oli528/StorePi/Electronics/Computations/Book1.xlsx

 | KSZ9563RNX |  | Current
 | A | D | mA
1.2 |  | ✓ | 250 |  | 5 | TPS65251-1RHAR | Analog
1.2 | ✓ |  | 190
2.5 | ✓ |  | 140 |  |  | TPS62420DRCTG4 | Digital
1.8 |  | ✓ | 35
 | ASM1184
 | A | D
1.2 |  | ✓ | 300
3.3 | ✓ |  | 1000
 | ASM1352R
 | A | D
3.3 |  | ✓ | 95
1.2 |  | ✓ | 440
1.2 | ✓
PG | Out |  | Detination | PG | IN | Origin
4 | PCIE_PWR_EN |  | 8 | 4 | PCIE_nCLKREQ | 8
4 | PCIE_CLK_P |  | 8 | 4 | PCIE_nWAKE | 8
4 | PCIE_CLK_N |  | 8 | 4 | PCIE_RX_P | 8
4 | PCIE_TX_P |  | 8 | 4 | PCIE_RX_N | 8
4 | PCIE_TX_N |  | 8 | 4 | USB3-0-RX_N | 9
4 | USB3-0-TX_N |  | 9 | 4 | USB3-0-RX_P | 9
4 | USB3-0-TX_P |  | 9 | 4 | USBOTG | 5
4 | PCIE_nRST |  | 8 | 4 | USB3-1-RX_N | 10
4 | USB3-1-TX_N |  | 10 | 4 | USB3-1-RX_P | 10
4 | USB3-1-TX_P |  | 10 | 4 | GPIO_VREF | 5
4 | USB2_N |  | 11 | 4 | ID_SC | 5
4 | USB2_P |  | 11 | 4 | ID_SD | 5
5 | ID_SD |  | 4 | 4 | CAM_GPIO0 | 5
5 | ID_SC |  | 4 | 4 | CAM_GPIO1 | 5
5 | GPIO_VREF |  | 4 | 4 | SCL0 | 5
5 | SCL0 |  | 4 | 4 | SDA0 | 5
5 | SDA0 |  | 4 | 4 | 3V3 | 7
5 | 3V3 |  | 7 | 5 | 5V S1 | 6
5 | CAM_GPIO0 |  | 4 | 5 | 12V | 6
5 | CAM_GPIO1 |  | 4 | 6 | Main Shut | 12
6 | 12V |  | 7, 9, 10 | 7 | 5V S1 | 6
7 | 5V S1 |  | 4,5,7,8,11,12 | 7 | 12V | 6
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
