oli528/StorePi/Electronics/Documentation/Specification.docx

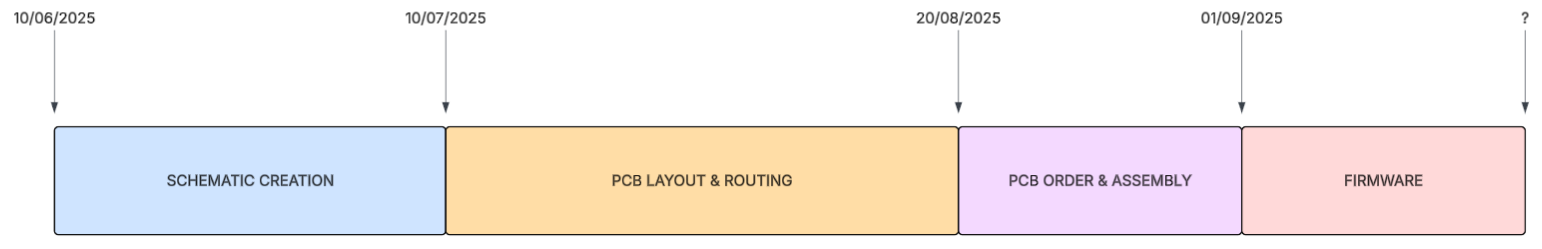
[picture p1: figure]
