oli528/StorePi/(list of files, drawings)

Other design files:
Electronics/Imported CM5 Nas/4DB-P108-03.SchLib
Electronics/Imported CM5 Nas/47018-2000.SchLib
Electronics/Imported CM5 Nas/10029364-001LF.SchLib
Electronics/Imported CM5 Nas/0039281063.SchLib
Electronics/Imported CM5 Nas/0877131001.SchLib
Electronics/Imported CM5 Nas/AOZ2255EQI-30.SchLib
Electronics/Imported CM5 Nas/AP62800SJ-7.SchLib
Electronics/Imported CM5 Nas/ASM1352R.SchLib
Electronics/Imported CM5 Nas/Block Diagram.SchDoc
Electronics/Imported CM5 Nas/CM5 Nas.PcbDoc
Electronics/Imported CM5 Nas/CM5 Nas.PrjPcb
Electronics/Imported CM5 Nas/CM5 Nas.SchDoc
Electronics/Imported CM5 Nas/CM5 Nas.SchLib
Electronics/Imported CM5 Nas/Drives_M.2.SchDoc
Electronics/Imported CM5 Nas/HD3SS3412RUAT.SchLib
Electronics/Imported CM5 Nas/JMS561.SchLib
Electronics/Imported CM5 Nas/JXD0-4015NL.SchLib
Electronics/Imported CM5 Nas/LM61480Q3RPHRQ1.SchLib
Electronics/Imported CM5 Nas/MAX20008AFOC_VY+T.SchLib
Electronics/Imported CM5 Nas/PI7C9X2G404ELZXAE.SchLib
Electronics/Imported CM5 Nas/Power.SchDoc
Electronics/Imported CM5 Nas/Project Architecture.SchDoc
Electronics/Imported CM5 Nas/RB1-125BAG1A.SchLib
Electronics/Imported CM5 Nas/RD-125A.SchLib
Electronics/Imported CM5 Nas/Revision History.SchDoc
Electronics/Imported CM5 Nas/RJMG212S21130ER.SchLib
Electronics/Imported CM5 Nas/SAT3M3232042TR.SchLib
Electronics/Imported CM5 Nas/Sata_Drives2.SchDoc
Electronics/Imported CM5 Nas/Sata_Drives.SchDoc
Electronics/Imported CM5 Nas/Section A - Title A.SchDoc
Electronics/Imported CM5 Nas/Section B - TItle B.SchDoc
Electronics/Imported CM5 Nas/SJA1105PEL.SchLib
Electronics/Imported CM5 Nas/SJA1105RELY.SchLib
Electronics/Imported CM5 Nas/SLG59M1717V.SchLib
Electronics/Imported CM5 Nas/TPS62420DRCTG4.SchLib
Electronics/Imported CM5 Nas/TPS65251-1RHAR.SchLib
Electronics/Imported CM5 Nas/TUSB9261IPVP.SchLib
Electronics/Imported CM5 Nas/untitled.SchDoc
Electronics/Imported CM5 Nas/USB2512B-AEZG.SchLib
Electronics/Imported CM5 Nas/USB & Ethernet.SchDoc
Electronics/Imported CM5 Nas/XT60PW-M.SchLib
