oli528/StorePi/Electronics/CM5 Nas.kicad_pcb

## KiCad design Electronics/CM5 Nas.kicad_pcb (2025-08-04)

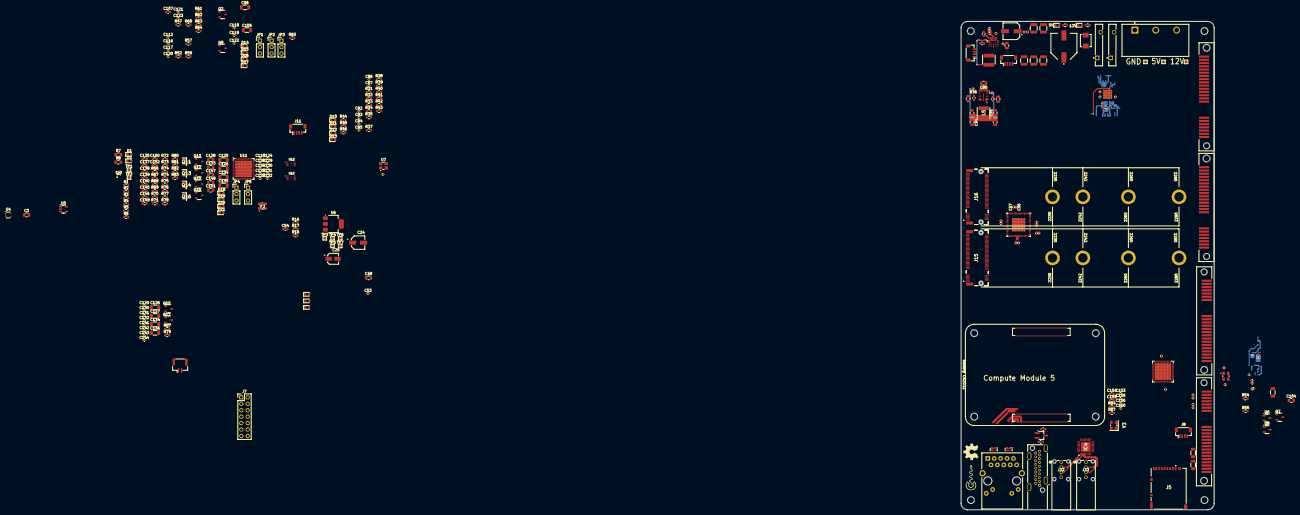
[picture p13: board CM5 Nas.kicad_pcb from above]

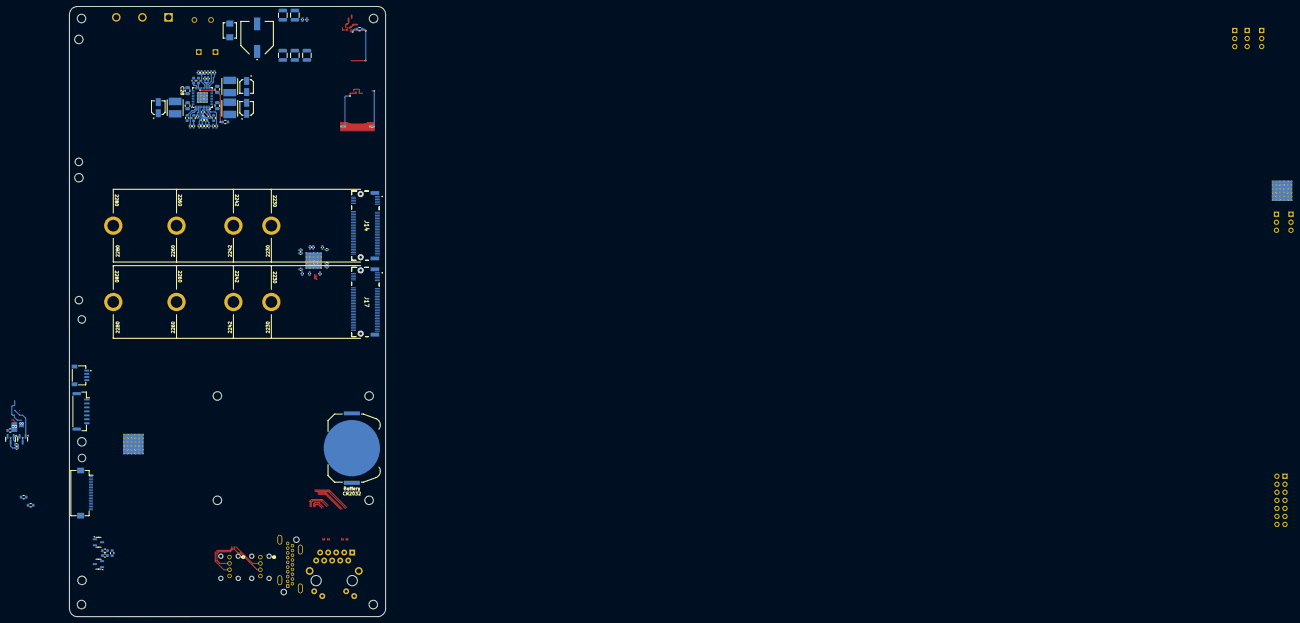
[picture p14: board CM5 Nas.kicad_pcb from below]

Board: 4 copper layers, 100.0 x 193.0 mm, 370 parts (78 on the bottom side), 312 nets.

Parts:
+5V1, +12V1: TestPoint; TestPoint_Pad_1.0x1.0mm
BT1: Battery_Cell; BatteryHolder_Keystone_3034_1x20mm
C1, C2, C42, C54, C137, C138, C139, C140, C145, C146, C149, C150, C152, C154, C159: 100n; C_0603_1608Metric
C3, C77, C81: 10u; C_0805_2012Metric
C4, C12: 1u; C_1210_3225Metric
C5, C13: 1000u; EEE0JA152UAP
C6, C7, C8, C9, C14, C15, C16, C17: 10u; C_1210_3225Metric
C10, C11, C18, C19, C44, C56, C57, C58, C59, C60, C61, C62, C63, C64, C65, C66, C67, C68, C69, C70, C71, C72, C73, C74, C75, C76, C79, C82, C83, C84, C85, C86, C87, C88, C89, C109, C110, C111, C112, C116, C117, C120, C121, C123#2: 100n; C_0402_1005Metric
C20, C21, C27, C28: 22u; C_0805_2012Metric
C22, C50, C51: 100p; C_0402_1005Metric
C23: 10u; C_0603_1608Metric
C24: 10u; CAP_EEEFK1H100UR
C25, C32, C34, C37: 22u; CAP_EEEFK1A220AR
C26, C30, C31, C38, C39, C40, C41, C46, C47: 4n7; C_0402_1005Metric
C29: 3u3; C_0603_1608Metric
C33, C35, C36: 47n; C_0402_1005Metric
C43: 100u; CAP_EEEFTH101XAP
C45, C48: 4u7; C_0805_2012Metric
C49, C53: 4u7; C_0402_1005Metric
C52: 2u2; C_0402_1005Metric
C55: 1n; C_0402_1005Metric
C78, C80: 0u47; C_0603_1608Metric
C90, C104, C128, C133, C147, C148, C151: 1u; C_0805_2012Metric
C91, C92, C93, C94: 47u; C_0805_2012Metric
C95, C96, C124, C125, C155, C156: 22p; C_0402_1005Metric
C96#2, C97, C98, C105, C106, C125#2, C126, C126#2, C127, C134, C134#2, C135, C136: 22u; C_1206_3216Metric
C99, C107, C135#2: 1u; C_0603_1608Metric
C100, C101, C102, C103, C108, C113, C114, C115, C119, C120#2, C123, C124#2, C129, C129#2, C130, C130#2, C131, C131#2, C132, C132#2, C141, C142, C143, C144: 10n; C_0402_1005Metric
C118, C119#2, C122: 1u; C_0402_1005Metric
C153, C160: 0u01; C_0402_1005Metric
D1, D3, D6, D7, D8, D9, D10, D11, D12, D13, D14, D15, D16, D17, D18, D19, D20, D21: LED Green; LED_0603_1608Metric
D2: LED Red; LED_0603_1608Metric
D4: D_TVS; SMBJ12A
D5: D_TVS; SMBJ5.0A
F1, F2: Polyfuse; RGEF1200
GND1: TestPoint; TestPoint_Pad_1.0x1.0mm
H1, H2, H3, H4, H5: MountingHole; MountingHole_2.7mm_M2.5
IC1: TPS65251-1RHAR; VQFN-40-1EP_6x6mm_P0.5mm_EP3.5x3.5mm_ThermalVias
IC2: MAX20008AFOC_VY+T; MAX20008AFOCVYT
IC3: LM61480Q3RPHRQ1; LM62460QRPHRQ1
IC4: USB2512B-AEZG; QFN50P600X600X100-37N-D
J1: HDMI_A; AMPHENOL_G45A19071083HR
J2: Conn_01x22_Female; Hirose_FH12-22S-0.5SH_1x22-1MP_P0.50mm_Horizontal
J3: RJ45_RB1-125B8G1A; RJ45_UDE_RB1-125B8G1A
J4: Conn_01x07; JST_GH_SM07B-GHS-TB_1x07-1MP_P1.25mm_Horizontal
J5: Micro_SD_Card_Det; DM3ATSFPEJM5
J6: Conn_01x04; SPARKFUN_PRT-14417
J7: Conn_02x07_Odd_Even; PinHeader_2x07_P2.54mm_Vertical
J8, J9, J11, J12: JST_SHBM04B-SRSS-TB; JST_SH_BM04B-SRSS-TB_1x04-1MP_P1.00mm_Vertical
J10: Conn_01x02; JST_GH_BM02B-GHS-TBT_1x02-1MP_P1.25mm_Vertical
J13: 4DB-P108-03; 4DBP10803
J14, J17: Bus_M.2_Socket_M; 21991195 no holes
J15, J16: Bus_M.2_Socket_M; 21991195
J18, J19, J20, J21: 0877131001; 87713-1001
J22, J23: USB_A; CONN_48204-0001_MOL
JP1, JP2, JP3, JP4, JP5: 3P_JUMPER; PinHeader_1x03_P2.54mm_Vertical
L1, L2, L3: 4u7; INDPM5050X400N
L4: 1u; SRN5040TA1R0M
L5: 2u2; SRN50402R2Y
Module1: ComputeModule5-CM5; Raspberry-Pi-5-Compute-Module
Q1: PMOS; BSS84AKW115
Q2, Q10, Q10#2, Q12, Q15, Q15#2, Q17: NPN; P200_SOT-23
Q2#2: MMBT3904; SOT-23
Q3, Q5, Q6, Q8: AOSS21311C; SOT-23-3
Q4: AOSS21311C; SOT-23
Q7, Q9: MMBT3904; P200_SOT-23
Q11, Q13, Q14, Q16: PMOS; SOT95P237X117-3N
R1, R2, R3, R18, R37, R38, R39, R40, R84: 1K; R_0603_1608Metric
R4, R43, R44, R45, R46: 1k; R_0603_1608Metric
R5, R6, R58, R71, R77: 4K7; R_0603_1608Metric
R7: 0R; R_0805_2012Metric_Pad1.20x1.40mm_HandSolder
R8: nf; R_0805_2012Metric_Pad1.20x1.40mm_HandSolder
R9: 2K2; R_0603_1608Metric
R10: 620; R_0603_1608Metric
R11: 20k; R_0402_1005Metric
R12, R31, R32, R33, R34, R35: 10K; R_0603_1608Metric
R13, R25: 80K6; R_0402_1005Metric
R14: 150k; R_0402_1005Metric
R15, R19, R20: 40K2; R_0402_1005Metric
R16, R17, R61, R62, R63, R64, R80, R81, R82, R83: 270; R_0603_1608Metric
R21: 120k; R_0603_1608Metric
R22: 150k; R_0603_1608Metric
R23: 20K; R_0603_1608Metric
R24: 12K7; R_0402_1005Metric
R26: 383k; R_0402_1005Metric
R27, R28: 20k; R_0603_1608Metric
R29: 22K; C_0402_1005Metric
R30: 12k; R_0603_1608Metric
R36: 10k; R_0402_1005Metric
R41, R42: 12K1; R_0603_1608Metric
R47, R52, R66, R72, R87: 12K; R_0603_1608Metric
R48, R49, R50, R54, R55, R56, R60, R65, R67, R67#2, R68, R69, R70, R73, R74, R74#2, R75, R79: 100K; R_0603_1608Metric
R51: 100K; R_0402_1005Metric
R53: 4K7; R_0402_1005Metric
R57, R76: 10; R_0603_1608Metric
R59, R78: 4K7 1%; R_0603_1608Metric
TP1, TP2, TP3, TP4, TP5, TP6, TP7: TestPoint; TestPoint_Pad_1.0x1.0mm
U1: RT9742SNGV; TSOT-23_HandSoldering
U2, U3: TPD4EUSB30; USON-10_2.5x1.0mm_P0.5mm
U4: 74LVC1G07SE-7; SOT-353_SC-70-5
U5: RT9742GGJ5; SOT-23-5
U6: AMS1117-3.3; SOT-223-3_TabPin2
U7: ASEK-32.768KHZ-L-R-T; Crystal_SMD_3225-4Pin_3.2x2.5mm
U8: ASM1184; QFN-64-1EP_9x9mm_P0.5mm_EP5.2x5.2mm_ThermalVias
U9, U11: JMS561; QFN-64-1EP_8x8mm_P0.4mm_EP6.5x6.5mm_ThermalVias
U10, U12: W25X20CLUXIG_TR; SON50P300X200X60-9N
Y1, Y2, Y3: 30MHz; ABM810000MHZ12D2W

Connections:
+1V2: C58.1, C59.1, C60.1, C61.1, C62.1, C63.1, C69.1, C70.1, C71.1, C72.1, C73.1, C74.1, U8.9 (1V2), U8.15 (1V2), U8.17 (1V2), U8.20 (1V2), U8.26 (1V2), U8.29 (1V2), U8.37 (1V2), U8.43 (1V2), U8.48 (1V2), U8.50 (1V2), U8.61 (1V2), U8.64 (1V2)
+3V3A: C82.1, C83.1, C84.1, C85.1, C86.1, C87.1, R31.1, R32.1, R33.1, R34.1, R35.1, U8.1 (3V_AUX), U8.10 (3V3), U8.21 (3V3), U8.32 (3V3), U8.38 (3V3), U8.56 (3V3)
+5V: R67.1, R74.1
+5V S1: C12.1, C13.1, C14.1, C15.1, C16.1, C17.1, C18.1, C19.1, D5.2 (A2), F2.2
+5V S2: Q5.3 (S), Q8.3 (S), Q13.3 (S), Q16.3 (S), R48.2, R60.1, R67#2.2, R79.2
+5V-HDD0: C96#2.1, C98.2, J18.14 (P7), J18.15 (P8), J18.16 (P9), Q5.1 (D)
+5V-HDD1: C106.2, J19.14 (P7), J19.15 (P8), J19.16 (P9), Q8.1 (D)
+5V-HDD2: C125#2.1, C127.2, J20.14 (P7), J20.15 (P8), J20.16 (P9), Q13.1 (D)
+5V-HDD3: C134.1, C136.2, J21.14 (P7), J21.15 (P8), J21.16 (P9), Q16.1 (D)
+12V: +12V1.1, C4.1, C5.1, C6.1, C7.1, C8.1, C9.1, C10.1, C11.1, C99.1, C104.1, C128.1, C133.1, D4.2 (A2), F1.1, F1.2, J13.3, Q3.3 (S), Q6.3 (S), Q11.3 (S), Q14.3 (S), R9.2, R49.2, R54.2, R68.2, R73.2
+12V-HDD0: C97.1, J18.20 (P13), J18.21 (P14), J18.22 (P15), Q3.1 (D)
+12V-HDD1: C105.1, J19.20 (P13), J19.21 (P14), J19.22 (P15), Q6.1 (D)
+12V-HDD2: C126.1, C126#2.1, J20.20 (P13), J20.21 (P14), J20.22 (P15), Q11.1 (D)
+12V-HDD3: C134#2.1, C135.1, J21.20 (P13), J21.21 (P14), J21.22 (P15), Q14.1 (D)
/Project Architecture/CM5_GPIO/+3V3: D1.2 (A), D2.2 (A), J3.L1, J3.L3, J3.R1 (CT), J4.1, J6.2, Module1.84 (+3.3v_(Output)), Module1.86 (+3.3v_(Output)), R5.1, R6.1, R7.1, U4.5 (VCC), U5.5 (IN)
/Project Architecture/CM5_GPIO/+5V: J11.1, Module1.77 (+5v_(Input)), Module1.79 (+5v_(Input)), Module1.81 (+5v_(Input)), Module1.83 (+5v_(Input)), Module1.85 (+5v_(Input)), Module1.87 (+5v_(Input))
/Project Architecture/CM5_GPIO/+12V: J8.1, J9.1, J12.1
/Project Architecture/CM5_GPIO/CM5 Shut: Module1.54 (GPIO4), Q1.2 (G)
/Project Architecture/CM5_GPIO/EEPROM_nWP: J7.4, Module1.20 (EEPROM_nWP)
/Project Architecture/CM5_GPIO/ETH_LEDG: Module1.17 (Ethernet_nLED2(3.3v)), R1.1
/Project Architecture/CM5_GPIO/ETH_LEDY: Module1.15 (Ethernet_nLED3(3.3v)), R2.1
/Project Architecture/CM5_GPIO/GPIO2: J6.4, Module1.58 (GPIO2), R6.2
/Project Architecture/CM5_GPIO/GPIO3: J6.3, Module1.56 (GPIO3), R5.2
/Project Architecture/CM5_GPIO/GPIO8: J4.5, Module1.39 (GPIO8)
/Project Architecture/CM5_GPIO/GPIO10: J4.3, Module1.44 (GPIO10)
/Project Architecture/CM5_GPIO/GPIO11: J4.4, Module1.38 (GPIO11)
/Project Architecture/CM5_GPIO/GPIO25: J4.6, Module1.41 (GPIO25)
/Project Architecture/CM5_GPIO/GPIO27: J4.7, Module1.48 (GPIO27)
/Project Architecture/CM5_GPIO/GPIO_VREF: Module1.78 (GPIO_VREF(1.8v/3.3v_Input)), R7.2, R8.2
/Project Architecture/CM5_GPIO/PMIC_ENABLE: J7.12, Module1.99 (PMIC_ENABLE)
/Project Architecture/CM5_GPIO/PWM_0: J11.2, Module1.19 (FAN_PWM)
/Project Architecture/CM5_GPIO/PWM_1: J8.2, Module1.31 (GPIO12)
/Project Architecture/CM5_GPIO/PWM_2: J9.2, Module1.28 (GPIO13)
/Project Architecture/CM5_GPIO/PWM_3: J12.2, Module1.55 (GPIO14)
/Project Architecture/CM5_GPIO/PWR_BUT: J7.14, J10.1, Module1.92 (PWR_BUT), Q1.1 (D)
/Project Architecture/CM5_GPIO/SD_CLK: J5.5 (CLK), Module1.57 (SD_CLK)
/Project Architecture/CM5_GPIO/SD_CMD: J5.3 (CMD), Module1.62 (SD_CMD)
/Project Architecture/CM5_GPIO/SD_DAT0: J5.7 (DAT0), Module1.63 (SD_DAT0)
/Project Architecture/CM5_GPIO/SD_DAT1: J5.8 (DAT1), Module1.67 (SD_DAT1)
/Project Architecture/CM5_GPIO/SD_DAT2: J5.1 (DAT2), Module1.69 (SD_DAT2)
/Project Architecture/CM5_GPIO/SD_DAT3: J5.2 (DAT3/CD), Module1.61 (SD_DAT3)
/Project Architecture/CM5_GPIO/SD_PWR: C3.1, J5.4 (VDD), U5.1 (OUT)
/Project Architecture/CM5_GPIO/SD_PWR_ON: Module1.75 (SD_PWR_ON), U5.4 (EN)
/Project Architecture/CM5_GPIO/SYNC_OUT: J7.6, Module1.18 (Ethernet_SYNC_OUT(3.3v))
/Project Architecture/CM5_GPIO/TACHO: J11.4, Module1.16 (FAN_TACHO)
/Project Architecture/CM5_GPIO/TRD0_N: J3.R3 (TD1-), Module1.10 (Ethernet_Pair0_N), U3.4 (D2+), U3.7
/Project Architecture/CM5_GPIO/TRD0_P: J3.R2 (TD1+), Module1.12 (Ethernet_Pair0_P), U3.5 (D2-), U3.6
/Project Architecture/CM5_GPIO/TRD1_N: J3.R5 (TD2-), Module1.6 (Ethernet_Pair1_N), U3.2 (D1-), U3.9
/Project Architecture/CM5_GPIO/TRD1_P: J3.R4 (TD2+), Module1.4 (Ethernet_Pair1_P), U3.1 (D1+), U3.10
/Project Architecture/CM5_GPIO/TRD2_N: J3.R7 (TD3-), Module1.9 (Ethernet_Pair2_N), U2.4 (D2+), U2.7
/Project Architecture/CM5_GPIO/TRD2_P: J3.R6 (TD3+), Module1.11 (Ethernet_Pair2_P), U2.5 (D2-), U2.6
/Project Architecture/CM5_GPIO/TRD3_N: J3.R9 (TD4-), Module1.5 (Ethernet_Pair3_N), U2.2 (D1-), U2.9
/Project Architecture/CM5_GPIO/TRD3_P: J3.R8 (TD4+), Module1.3 (Ethernet_Pair3_P), U2.1 (D1+), U2.10
/Project Architecture/CM5_GPIO/VBAT: BT1.1 (+), Module1.76 (VBAT)
/Project Architecture/CM5_GPIO/nPWR_LED: Module1.95 (LED_nPWR), U4.2
/Project Architecture/CM5_GPIO/nRPIBOOT: J7.2, Module1.93 (nRPIBOOT)
/Project Architecture/CM5_High Speed IO/+5V S1: C1.1, U1.1 (IN)
/Project Architecture/CM5_High Speed IO/DPHY0_C_N: J2.8, Module1.127 (MIPI0_C_N)
/Project Architecture/CM5_High Speed IO/DPHY0_C_P: J2.9, Module1.129 (MIPI0_C_P)
/Project Architecture/CM5_High Speed IO/DPHY0_D0_N: J2.2, Module1.115 (MIPI0_D0_N)
/Project Architecture/CM5_High Speed IO/DPHY0_D0_P: J2.3, Module1.117 (MIPI0_D0_P)
/Project Architecture/CM5_High Speed IO/DPHY0_D1_N: J2.5, Module1.121 (MIPI0_D1_N)
/Project Architecture/CM5_High Speed IO/DPHY0_D1_P: J2.6, Module1.123 (MIPI0_D1_P)
/Project Architecture/CM5_High Speed IO/DPHY0_D2_N: J2.11, Module1.133 (MIPI0_D2_N)
/Project Architecture/CM5_High Speed IO/DPHY0_D2_P: J2.12, Module1.135 (MIPI0_D2_P)
/Project Architecture/CM5_High Speed IO/DPHY0_D3_N: J2.14, Module1.139 (MIPI0_D3_N)
/Project Architecture/CM5_High Speed IO/DPHY0_D3_P: J2.15, Module1.141 (MIPI0_D3_P)
/Project Architecture/CM5_High Speed IO/HDMI0_CEC: J1.13 (CEC), Module1.151 (HDMI0_CEC)
/Project Architecture/CM5_High Speed IO/HDMI0_CK_N: J1.12 (CK-), Module1.190 (HDMI0_CLK_N)
/Project Architecture/CM5_High Speed IO/HDMI0_CK_P: J1.10 (CK+), Module1.188 (HDMI0_CLK_P)
/Project Architecture/CM5_High Speed IO/HDMI0_D0_N: J1.9 (D0-), Module1.184 (HDMI0_TX0_N)
/Project Architecture/CM5_High Speed IO/HDMI0_D0_P: J1.7 (D0+), Module1.182 (HDMI0_TX0_P)
/Project Architecture/CM5_High Speed IO/HDMI0_D1_N: J1.6 (D1-), Module1.178 (HDMI0_TX1_N)
/Project Architecture/CM5_High Speed IO/HDMI0_D1_P: J1.4 (D1+), Module1.176 (HDMI0_TX1_P)
/Project Architecture/CM5_High Speed IO/HDMI0_D2_N: J1.3 (D2-), Module1.172 (HDMI0_TX2_N)
/Project Architecture/CM5_High Speed IO/HDMI0_D2_P: J1.1 (D2+), Module1.170 (HDMI0_TX2_P)
/Project Architecture/CM5_High Speed IO/HDMI0_HOTPLUG: J1.19 (HPD), Module1.153 (HDMI0_HOTPLUG)
/Project Architecture/CM5_High Speed IO/HDMI0_SCL: J1.15 (SCL), Module1.200 (HDMI0_SCL)
/Project Architecture/CM5_High Speed IO/HDMI0_SDA: J1.16 (SDA), Module1.199 (HDMI0_SDA)
/Project Architecture/CM5_High Speed IO/HDMI_5v: C2.1, J1.18 (+5V), U1.2 (OUT)
/Project Architecture/Input/+5V: +5V1.1, F2.1, J13.2
/Project Architecture/M.2 Drives/+3V3 M.2: C64.1, C91.1, C92.1, C93.1, C94.1, D10.2 (A), D11.2 (A), D12.2 (A), D13.2 (A), IC3.5 (BIAS), IC3.7 (FB), J14.2 (3.3V), J14.4 (3.3V), J14.70 (3.3V), J14.72 (3.3V), J14.74 (3.3V), J15.2 (3.3V), J15.4 (3.3V), J15.70 (3.3V), J15.72 (3.3V), J15.74 (3.3V), J16.2 (3.3V), J16.4 (3.3V), J16.70 (3.3V), J16.72 (3.3V), J16.74 (3.3V), J17.2 (3.3V), J17.4 (3.3V), J17.70 (3.3V), J17.72 (3.3V), J17.74 (3.3V), L5.2, R36.2, U7.1 (EN), U7.4 (VDD)
/Project Architecture/M.2 Drives/+5V S1: C77.2, C78.2, C80.1, C81.1, IC3.2 (VIN2), IC3.13 (EN), IC3.14 (VIN1)
/Project Architecture/M.2 Drives/BOOT: C79.1, IC3.16 (SW), L5.1
/Project Architecture/M.2 Drives/PCIE_nCLKREQ: J14.52 (~CLKREQ), J15.52 (~CLKREQ), J16.52 (~CLKREQ), J17.52 (~CLKREQ)
/Project Architecture/M.2 Drives/PCIE_nWAKE: J14.54 (~PEWAKE), J15.54 (~PEWAKE), J16.54 (~PEWAKE), J17.54 (~PEWAKE)
/Project Architecture/M.2 Drives/PCIe_CLK_N_1: J16.53 (REFCLKn), U8.19 (REFCLKN_1)
/Project Architecture/M.2 Drives/PCIe_CLK_N_2: J17.53 (REFCLKn), U8.28 (REFCLKN_2)
/Project Architecture/M.2 Drives/PCIe_CLK_N_3: J15.53 (REFCLKn), U8.45 (REFCLKN_3)
/Project Architecture/M.2 Drives/PCIe_CLK_N_4: J14.53 (REFCLKn), U8.63 (REFCLKN_4)
/Project Architecture/M.2 Drives/PCIe_CLK_P_1: J16.55 (REFCLKp), U8.18 (REFCLKP_1)
/Project Architecture/M.2 Drives/PCIe_CLK_P_2: J17.55 (REFCLKp), U8.27 (REFCLKP_2)
/Project Architecture/M.2 Drives/PCIe_CLK_P_3: J15.55 (REFCLKp), U8.44 (REFCLKP_3)
/Project Architecture/M.2 Drives/PCIe_CLK_P_4: J14.55 (REFCLKp), U8.62 (REFCLKP_4)
/Project Architecture/M.2 Drives/PCIe_RX_N_1: J16.41 (PETn0), U8.14 (RXN_1)
/Project Architecture/M.2 Drives/PCIe_RX_N_2: J17.41 (PETn0), U8.25 (RXN_2)
/Project Architecture/M.2 Drives/PCIe_RX_N_3: J15.41 (PETn0), U8.42 (RXN_3)
/Project Architecture/M.2 Drives/PCIe_RX_N_4: J14.41 (PETn0), U8.60 (RXN_4)
/Project Architecture/M.2 Drives/PCIe_RX_P_1: J16.43 (PETp0), U8.13 (RXP_1)
/Project Architecture/M.2 Drives/PCIe_RX_P_2: J17.43 (PETp0), U8.24 (RXP_2)
/Project Architecture/M.2 Drives/PCIe_RX_P_3: J15.43 (PETp0), U8.41 (RXP_3)
/Project Architecture/M.2 Drives/PCIe_RX_P_4: J14.43 (PETp0), U8.59 (RXP_4)
/Project Architecture/M.2 Drives/PCIe_TX_N_1: C57.1, J16.47 (PERn0)
/Project Architecture/M.2 Drives/PCIe_TX_N_2: C66.1, J17.47 (PERn0)
/Project Architecture/M.2 Drives/PCIe_TX_N_3: C68.1, J15.47 (PERn0)
/Project Architecture/M.2 Drives/PCIe_TX_N_4: C76.1, J14.47 (PERn0)
/Project Architecture/M.2 Drives/PCIe_TX_P_1: C56.1, J16.49 (PERp0)
/Project Architecture/M.2 Drives/PCIe_TX_P_2: C65.1, J17.49 (PERp0)
/Project Architecture/M.2 Drives/PCIe_TX_P_3: C67.1, J15.49 (PERp0)
/Project Architecture/M.2 Drives/PCIe_TX_P_4: C75.1, J14.49 (PERp0)
/Project Architecture/M.2 Drives/PERST: J14.50 (~PERST), J15.50 (~PERST), J16.50 (~PERST), J17.50 (~PERST), U8.2 (RES_OUT)
/Project Architecture/M.2 Drives/RS1: IC3.10 (~RESET_1), IC3.19 (~RESET_2), R36.1
/Project Architecture/M.2 Drives/SUSCLK: J14.68 (SUSCLK), J15.68 (SUSCLK), J16.68 (SUSCLK), J17.68 (SUSCLK), U7.3 (Out)
/Project Architecture/M.2 Drives/TX_N_3: C68.2, U8.40 (TXN_3)
/Project Architecture/M.2 Drives/TX_P_3: C67.2, U8.39 (TXP_3)
/Project Architecture/M.2 Drives/VCC: C90.1, IC3.6 (VCC_1), IC3.9 (RT), IC3.11 (SPSP), IC3.18 (VCC_2)
/Project Architecture/Power/+1V2: C37.1, C39.1, L3.2, R12.1, R20.1, TP6.1
/Project Architecture/Power/+1V2A: C31.1, C32.1, L1.2, R15.1, TP4.1
/Project Architecture/Power/+3V3: C25.1, R16.2, TP3.1, U6.2 (VO)
/Project Architecture/Power/+3V3A: C34.1, C38.1, L2.2, R17.2, R19.1, TP5.1
/Project Architecture/Power/+5V S1: C20.2, C21.2, C24.1, C27.2, C28.1, IC1.11 (EN1), IC1.13 (VIN1), IC1.18 (VIN2), IC1.20 (EN2), IC1.32 (VIN_1), IC1.33 (VIN_2), IC1.34 (VIN_3), IC1.38 (VIN3), IC1.40 (EN3), U6.3 (VI)
/Project Architecture/Power/+5V S2: C48.1, IC2.1 (OUT), L4.2, R18.2, R23.1, TP7.1
/Project Architecture/Power/FB1: C39.2, IC1.7 (FB1), R20.2, R25.1
/Project Architecture/Power/FB2: C31.2, IC1.24 (FB2), R13.1, R15.2
/Project Architecture/Power/FB3: C38.2, IC1.4 (FB3), R19.2, R24.1
/Project Architecture/Power/SUP: C43.1, C44.1, C45.1, C53.1, C54.1, IC2.9 (SUPSW), IC2.10 (SUP), IC2.11 (EN)
/Project Architecture/Sata Drives 1/1V2A: C119#2.1, C120.1, C121.1, C122.1, C123#2.1, U9.29 (UA-VCCK), U9.37 (SA-VCCK), U9.40 (SA-VCCK), U9.46 (SA-VCCK)
/Project Architecture/Sata Drives 1/1V2D: C116.1, C117.1, C118.1, U9.4 (VCCK), U9.12 (VCCK), U9.17 (VCCK), U9.20 (VCCK), U9.32 (UA-VCCK), U9.51 (VCCK), U9.57 (VCCK)
/Project Architecture/Sata Drives 1/3V3: C109.1, C110.1, JP1.1 (A), JP2.1 (A), R59.1, R65.2, U9.10 (VCCO), U9.52 (VCCO), U10.8 (VCC)
/Project Architecture/Sata Drives 1/3V3A: C111.1, C112.1, U9.26 (UA-VCCH), U9.33 (XA-VCCH), U9.43 (SA-VCCH)
/Project Architecture/Sata Drives 1/GPIO1: R59.2, U9.1 (GPIO1/RX)
/Project Architecture/Sata Drives 1/GPIO2: U9.18 (GPIO2/PSSO), U10.1 (~CS)
/Project Architecture/Sata Drives 1/GPIO5: JP1.2 (C), U9.6 (GPIO5/MISO)
/Project Architecture/Sata Drives 1/GPIO7: JP2.2 (C), U9.5 (GPIO7/SSI)
/Project Architecture/Sata Drives 1/GPIO8: R56.2, R58.1, U9.8 (GPIO8/D1_PWR)
/Project Architecture/Sata Drives 1/GPIO9: R51.2, R53.1, U9.50 (GPIO9/D0_PWR)
/Project Architecture/Sata Drives 1/GPIO10: R62.1, U9.53 (GPIO10/LED2)
/Project Architecture/Sata Drives 1/GPIO11: R61.1, U9.55 (GPIO11/LED0)
/Project Architecture/Sata Drives 1/GPIO12: R63.1, U9.11 (GPIO12/LED1)
/Project Architecture/Sata Drives 1/GPIO13: U9.15 (GPIO13/PMOSI), U10.5 (DI(IO0))
/Project Architecture/Sata Drives 1/GPIO14: R64.1, U9.9 (GPIO14/LED3)
/Project Architecture/Sata Drives 1/GPIO15: U9.13 (GPIO15/PSCK), U10.6 (CLK)
/Project Architecture/Sata Drives 1/GPIO16: U9.14 (GPIO16/PMISO), U10.2 (DO(IO1))
/Project Architecture/Sata Drives 1/HDD0_DET: Q2.1 (C), Q2#2.1 (C), Q4.2 (B), R51.1
/Project Architecture/Sata Drives 1/HDD1_DET: Q7.2 (B), Q9.1 (C), R56.1
/Project Architecture/Sata Drives 1/S0_RXN: C103.1, U9.39 (S0-RXN)
/Project Architecture/Sata Drives 1/S0_RXP: C102.1, U9.38 (S0-RXP)
/Project Architecture/Sata Drives 1/S0_TXN: C100.1, U9.41 (S0-TXN)
/Project Architecture/Sata Drives 1/S0_TXP: C101.1, U9.42 (S0-TXP)
/Project Architecture/Sata Drives 1/S1_RXN: C115.1, U9.45 (S1-RXN)
/Project Architecture/Sata Drives 1/S1_RXP: C114.1, U9.44 (S1-RXP)
/Project Architecture/Sata Drives 1/S1_TXN: C108.1, U9.47 (S1-TXN)
/Project Architecture/Sata Drives 1/S1_TXP: C113.1, U9.48 (S1-TXP)
/Project Architecture/Sata Drives 1/S-REXT: R47.1, U9.36 (S-REXT)
/Project Architecture/Sata Drives 1/U-REXT: R52.2, U9.25 (UREXT)
/Project Architecture/Sata Drives 1/VBUS-S: C107.1, R57.1, U9.16 (VBUS_SENSE)
/Project Architecture/Sata Drives 1/XIN: C95.1, U9.35 (XI), Y1.1
/Project Architecture/Sata Drives 1/XOUT: C96.1, U9.34 (XO), Y1.3
/Project Architecture/Sata Drives 2/1V2A: C148.1, C149.1, C150.1, C151.1, C152.1, U11.29 (UA-VCCK), U11.37 (SA-VCCK), U11.40 (SA-VCCK), U11.46 (SA-VCCK)
/Project Architecture/Sata Drives 2/1V2D: C145.1, C146.1, C147.1, U11.4 (VCCK), U11.12 (VCCK), U11.17 (VCCK), U11.20 (VCCK), U11.32 (UA-VCCK), U11.51 (VCCK), U11.57 (VCCK)
/Project Architecture/Sata Drives 2/3V3: C137.1, C138.1, JP4.1 (A), JP5.1 (A), R78.1, U11.10 (VCCO), U11.52 (VCCO), U12.8 (VCC)
/Project Architecture/Sata Drives 2/3V3A: C139.1, C140.1, U11.26 (UA-VCCH), U11.33 (XA-VCCH), U11.43 (SA-VCCH)
/Project Architecture/Sata Drives 2/GPIO1: R78.2, U11.1 (GPIO1/RX)
/Project Architecture/Sata Drives 2/GPIO2: U11.18 (GPIO2/PSSO), U12.1 (~CS)
/Project Architecture/Sata Drives 2/GPIO5: JP4.2 (C), U11.6 (GPIO5/MISO)
/Project Architecture/Sata Drives 2/GPIO7: JP5.2 (C), U11.5 (GPIO7/SSI)
/Project Architecture/Sata Drives 2/GPIO8: R75.2, R77.1, U11.8 (GPIO8/D1_PWR)
/Project Architecture/Sata Drives 2/GPIO9: R70.2, R71.1, U11.50 (GPIO9/D0_PWR)
/Project Architecture/Sata Drives 2/GPIO10: R81.1, U11.53 (GPIO10/LED2)
/Project Architecture/Sata Drives 2/GPIO11: R80.1, U11.55 (GPIO11/LED0)
/Project Architecture/Sata Drives 2/GPIO12: R82.1, U11.11 (GPIO12/LED1)
/Project Architecture/Sata Drives 2/GPIO13: U11.15 (GPIO13/PMOSI), U12.5 (DI(IO0))
/Project Architecture/Sata Drives 2/GPIO14: R83.1, U11.9 (GPIO14/LED3)
/Project Architecture/Sata Drives 2/GPIO15: U11.13 (GPIO15/PSCK), U12.6 (CLK)
/Project Architecture/Sata Drives 2/GPIO16: U11.14 (GPIO16/PMISO), U12.2 (DO(IO1))
/Project Architecture/Sata Drives 2/HDD2_DET: Q10.1 (C), Q10#2.1 (C), Q12.2 (B), R70.1
/Project Architecture/Sata Drives 2/HDD3_DET: Q15.1 (C), Q15#2.2 (B), Q17.1 (C), R75.1
/Project Architecture/Sata Drives 2/S2_RXN: C124#2.1, C132.1, U11.39 (S0-RXN)
/Project Architecture/Sata Drives 2/S2_RXP: C123.1, C131.1, U11.38 (S0-RXP)
/Project Architecture/Sata Drives 2/S2_TXN: C119.1, C129#2.1, U11.41 (S0-TXN)
/Project Architecture/Sata Drives 2/S2_TXP: C120#2.1, C130.1, C130#2.1, C142.1, U11.42 (S0-TXP)
/Project Architecture/Sata Drives 2/S3_RXN: C132#2.1, C144.1, U11.45 (S1-RXN)
/Project Architecture/Sata Drives 2/S3_RXP: C131#2.1, C143.1, U11.44 (S1-RXP)
/Project Architecture/Sata Drives 2/S3_TXN: C129.1, C141.1, U11.47 (S1-TXN)
/Project Architecture/Sata Drives 2/S-REXT: R66.1, U11.36 (S-REXT)
/Project Architecture/Sata Drives 2/U-REXT: R72.2, U11.25 (UREXT)
/Project Architecture/Sata Drives 2/VBUS-S: C135#2.1, R76.1, U11.16 (VBUS_SENSE)
/Project Architecture/Sata Drives 2/XIN: C124.1, U11.35 (XI), Y2.1
/Project Architecture/Sata Drives 2/XOUT: C125.1, U11.34 (XO), Y2.3
/Project Architecture/Usb Switch/+3V3: IC4.15 (VDD33_1), IC4.23 (VDD33_2), IC4.26 (RESET_N), R84.1
/Project Architecture/Usb Switch/+3V3A: IC4.5 (VDDA33_1), IC4.10 (VDDA33_2), IC4.29 (VDDA33_3), IC4.36 (VDDA33_4)
/Project Architecture/Usb Switch/+5V S1: J22.1 (VBUS), J23.1 (VBUS)
/Project Architecture/Usb Switch/D1+: IC4.2 (USBDP_DN1/PRT_DIS_P1), J22.3 (D+)
/Project Architecture/Usb Switch/D1-: IC4.1 (USBDM_DN1/PRT_DIS_M1), J22.2 (D-)
/Project Architecture/Usb Switch/D2+: IC4.4 (USBDP_DN2/PRT_DIS_P2), J23.3 (D+)
/Project Architecture/Usb Switch/D2-: IC4.3 (USBDM_DN2/PRT_DIS_M2), J23.2 (D-)
/Project Architecture/Usb Switch/XIN: C155.1, IC4.33 (XTALIN/CLKIN), Y3.1
/Project Architecture/Usb Switch/XOUT: C156.1, IC4.32 (XTALOUT), Y3.3
unnamed: C26.1, R11.2
unnamed: C46.1, R27.2
unnamed: C47.1, R28.2
unnamed: C55.1, R29.2
unnamed: D1.1 (K), R3.1, TP1.1
unnamed: D2.1 (K), R4.1, TP2.1
unnamed: D3.2 (A), R9.1
unnamed: D6.2 (A), R10.1
unnamed: D7.2 (A), R16.1
unnamed: D8.2 (A), R17.1
unnamed: D9.2 (A), R18.1
unnamed: D10.1 (K), R46.1
unnamed: D11.1 (K), R43.1
unnamed: D12.1 (K), R44.1
unnamed: D13.1 (K), R45.1
unnamed: D14.2 (A), R61.2
unnamed: D15.2 (A), R62.2
unnamed: D16.2 (A), R63.2
unnamed: D17.2 (A), R64.2
unnamed: D18.2 (A), R80.2
unnamed: D19.2 (A), R81.2
unnamed: D20.2 (A), R82.2
unnamed: D21.2 (A), R83.2
unnamed: C36.1, IC1.12 (BST1)
unnamed: C33.2, IC1.19 (BST2)
unnamed: C35.1, IC1.39 (BST3)
unnamed: C51.1, IC1.8 (CMP1), R28.1
unnamed: C50.1, IC1.3 (CMP3), R27.1
unnamed: C22.1, IC1.23 (COMP2), R11.1
unnamed: C36.2, IC1.14 (LX1_1), IC1.15 (LX1_2), L3.1
unnamed: C33.1, IC1.16 (LX2_1), IC1.17 (LX2_2), L1.1
unnamed: C35.2, IC1.36 (LX3_1), IC1.37 (LX3_2), L2.1
unnamed: IC1.27 (PGOOD), R12.2
unnamed: IC1.10 (RLIM1), R22.1
unnamed: IC1.21 (RLIM2), R14.1
unnamed: IC1.1 (RLIM3), R21.1
unnamed: IC1.6 (ROSC), R26.2
unnamed: C41.1, IC1.9 (SS1)
unnamed: C30.1, IC1.22 (SS2)
unnamed: C40.1, IC1.2 (SS3)
unnamed: C29.2, IC1.29 (V3V)
unnamed: C23.2, IC1.28 (V7V)
unnamed: C52.2, IC2.13 (BIAS), IC2.16 (FB)
unnamed: C42.1, IC2.3 (BST)
unnamed: C49.1, IC2.15 (COMP), R29.1
unnamed: IC2.17 (FOSC), R30.1
unnamed: C42.2, IC2.6 (LX), L4.1
unnamed: IC2.2 (~RESET), R23.2
unnamed: C79.2, IC3.3 (RBOOT), IC3.4 (CBOOT)
unnamed: C153.1, C154.1, IC4.14 (CRFILT)
unnamed: C159.1, C160.1, IC4.34 (PLLFILT)
unnamed: IC4.35 (RBIAS), R87.2
unnamed: IC4.27 (VBUS_DET), R84.2
unnamed: J3.L2, R1.2
unnamed: J3.L4, R2.2
unnamed: J14.10 (DAS/~DSS/~LED1), R43.2
unnamed: J15.10 (DAS/~DSS/~LED1), R44.2
unnamed: J16.10 (DAS/~DSS/~LED1), R45.2
unnamed: J17.10 (DAS/~DSS/~LED1), R46.2
unnamed: J18.12 (P5), Q2#2.2 (B), R48.1
unnamed: C103.2, J18.2 (S2)
unnamed: C102.2, J18.3 (S3)
unnamed: C101.2, J18.5 (S5)
unnamed: C100.2, J18.6 (S6)
unnamed: J19.12 (P5), Q9.2 (B), R60.2
unnamed: C115.2, J19.2 (S2)
unnamed: C114.2, J19.3 (S3)
unnamed: C113.2, J19.5 (S5)
unnamed: C108.2, J19.6 (S6)
unnamed: J20.12 (P5), Q10#2.2 (B), R67#2.1
unnamed: C132.2, J20.2 (S2)
unnamed: C131.2, J20.3 (S3)
unnamed: C130#2.2, J20.5 (S5)
unnamed: C129#2.2, J20.6 (S6)
unnamed: J21.12 (P5), Q17.2 (B), R79.1
unnamed: C144.2, J21.2 (S2)
unnamed: C143.2, J21.3 (S3)
unnamed: C142.2, J21.5 (S5)
unnamed: C141.2, J21.6 (S6)
unnamed: JP3.1 (A), R65.1, U10.3 (~WP)
unnamed: Module1.21 (LED_nACT), R3.2
unnamed: C99.2, Q3.2 (G), Q5.2 (G), R50.2
unnamed: Q4.1 (C), R49.1, R50.1
unnamed: C104.2, Q6.2 (G), Q8.2 (G), R55.2
unnamed: Q7.1 (C), R54.1, R55.1
unnamed: Q10.2 (B), R67.2
unnamed: C128.2, Q11.2 (G), Q13.2 (G), R69.2
unnamed: Q12.1 (C), R68.1, R69.1
unnamed: C133.2, Q14.2 (G), Q16.2 (G), R74#2.2
unnamed: Q15.2 (B), R74.2
unnamed: Q15#2.1 (C), R73.1, R74#2.1
unnamed: R4.2, U4.4
unnamed: U2.3 (GND), U2.8 (GND)
unnamed: U3.3 (GND), U3.8 (GND)
unnamed: R35.2, U8.4 (GPIO_0)
unnamed: R31.2, U8.31 (GPIO_1)
unnamed: R38.1, U8.5 (GPIO_2)
unnamed: R34.2, U8.34 (GPIO_3)
unnamed: R37.1, U8.8 (GPIO_4)
unnamed: R32.2, U8.30 (GPIO_5)
unnamed: R39.1, U8.35 (GPIO_6)
unnamed: R33.2, U8.36 (GPIO_7)
unnamed: R41.1, U8.16 (REXT1)
unnamed: R42.1, U8.49 (REXT2)
unnamed: R40.1, U8.33 (TEST_EN)
unnamed: C57.2, U8.12 (TXN_1)
unnamed: C66.2, U8.23 (TXN_2)
unnamed: C76.2, U8.58 (TXN_4)
unnamed: C89.2, U8.55 (TXN_IN)
unnamed: C56.2, U8.11 (TXP_1)
unnamed: C65.2, U8.22 (TXP_2)
unnamed: C75.2, U8.57 (TXP_4)
unnamed: C88.2, U8.54 (TXP_IN)
gnd: BT1.2 (-), C1.2, C2.2, C3.2, C4.2, C5.2, C6.2, C7.2, C8.2, C9.2, C10.2, C11.2, C12.2, C13.2, C14.2, C15.2, C16.2, C17.2, C18.2, C19.2, C20.1, C21.1, C22.2, C23.1, C24.2, C25.2, C26.2, C27.1, C28.2, C29.1, C30.2, C32.2, C34.2, C37.2, C40.2, C41.2, C43.2, C44.2, C45.2, C46.2, C47.2, C48.2, C49.2, C50.2, C51.2, C52.1, C53.2, C54.2, C55.2, C58.2, C59.2, C60.2, C61.2, C62.2, C63.2, C64.2, C69.2, C70.2, C71.2, C72.2, C73.2, C74.2, C77.1, C78.1, C80.2, C81.2, C82.2, C83.2, C84.2, C85.2, C86.2, C87.2, C90.2, C91.2, C92.2, C93.2, C94.2, C95.2, C96.2, C96#2.2, C97.2, C98.1, C105.2, C106.1, C107.2, C109.2, C110.2, C111.2, C112.2, C116.2, C117.2, C118.2, C119#2.2, C120.2, C121.2, C122.2, C123#2.2, C124.2, C125.2, C125#2.2, C126.2, C126#2.2, C127.1, C134.2, C134#2.2, C135.2, C135#2.2, C136.1, C137.2, C138.2, C139.2, C140.2, C145.2, C146.2, C147.2, C148.2, C149.2, C150.2, C151.2, C152.2, C153.2, C154.2, C155.2, C156.2, C159.2, C160.2, D3.1 (K), D4.1 (A1), D5.1 (A1), D6.1 (K), D7.1 (K), D8.1 (K), D9.1 (K), D14.1 (K), D15.1 (K), D16.1 (K), D17.1 (K), D18.1 (K), D19.1 (K), D20.1 (K), D21.1 (K), GND1.1, IC1.25 (LOW_P), IC1.26 (GND_1), IC1.30 (AGND), IC1.31 (GND_2), IC1.35 (GND_3), IC1.41 (EP), IC2.4 (PGND_1), IC2.5 (PGND_2), IC2.7 (PGND_3), IC2.8 (PGND_4), IC2.12 (SYNC), IC2.14 (GND), IC3.1 (PGND2_1), IC3.8 (AGND), IC3.12 (SYNC/_MODE), IC3.15 (PGND1_1), IC3.17 (PGND2_2), IC3.20 (PGND1_2), IC4.37 (GROUND_PAD_(VSS)), J1.2 (D2S), J1.5 (D1S), J1.8 (D0S), J1.11 (CKS), J1.17 (GND), J2.1, J2.4, J2.7, J2.10, J2.13, J2.16, J2.19, J3.R10 (GND), J3.SH, J4.2, J5.6 (VSS), J6.1, J7.1, J7.3, J7.5, J7.7, J7.9, J7.11, J7.13, J8.3, J9.3, J10.2, J11.3, J12.3, J13.1, J14.1 (GND), J14.3 (GND), J14.9 (GND), J14.21 (GND), J14.27 (GND), J14.33 (GND), J14.39 (GND), J14.45 (GND), J14.51 (GND), J14.57 (GND), J14.71 (GND), J14.73 (GND), J14.75 (GND), J15.1 (GND), J15.3 (GND), J15.9 (GND), J15.21 (GND), J15.27 (GND), J15.33 (GND), J15.39 (GND), J15.45 (GND), J15.51 (GND), J15.57 (GND), J15.71 (GND), J15.73 (GND), J15.75 (GND), J15.M1 (GND2230), J15.M2 (GND2242), J15.M3 (GND2260), J15.M4 (GND2280), J16.1 (GND), J16.3 (GND), J16.9 (GND), J16.21 (GND), J16.27 (GND), J16.33 (GND), J16.39 (GND), J16.45 (GND), J16.51 (GND), J16.57 (GND), J16.71 (GND), J16.73 (GND), J16.75 (GND), J16.M1 (GND2230), J16.M2 (GND2242), J16.M3 (GND2260), J16.M4 (GND2280), J17.1 (GND), J17.3 (GND), J17.9 (GND), J17.21 (GND), J17.27 (GND), J17.33 (GND), J17.39 (GND), J17.45 (GND), J17.51 (GND), J17.57 (GND), J17.71 (GND), J17.73 (GND), J17.75 (GND), J18.1 (S1), J18.4 (S4), J18.7 (S7), J18.11 (P4), J18.13 (P6), J18.17 (P10), J18.18 (P11), J18.19 (P12), J19.1 (S1), J19.4 (S4), J19.7 (S7), J19.11 (P4), J19.13 (P6), J19.17 (P10), J19.18 (P11), J19.19 (P12), J20.1 (S1), J20.4 (S4), J20.7 (S7), J20.11 (P4), J20.13 (P6), J20.17 (P10), J20.18 (P11), J20.19 (P12), J21.1 (S1), J21.4 (S4), J21.7 (S7), J21.11 (P4), J21.13 (P6), J21.17 (P10), J21.18 (P11), J21.19 (P12), J22.4 (GND), J23.4 (GND), JP1.3 (B), JP2.3 (B), JP3.2 (C), JP4.3 (B), JP5.3 (B), Module1.1 (GND), Module1.2 (GND), Module1.7 (GND), Module1.8 (GND), Module1.13 (GND), Module1.14 (GND), Module1.22 (GND), Module1.23 (GND), Module1.32 (GND), Module1.33 (GND), Module1.42 (GND), Module1.43 (GND), Module1.52 (GND), Module1.53 (GND), Module1.59 (GND), Module1.60 (GND), Module1.65 (GND), Module1.66 (GND), Module1.71 (GND), Module1.74 (GND), Module1.98 (GND), Module1.107 (GND), Module1.108 (GND), Module1.113 (GND), Module1.114 (GND), Module1.119 (GND), Module1.120 (GND), Module1.125 (GND), Module1.126 (GND), Module1.131 (GND), Module1.132 (GND), Module1.137 (GND), Module1.138 (GND), Module1.144 (GND), Module1.150 (GND), Module1.155 (GND), Module1.156 (GND), Module1.161 (GND), Module1.162 (GND), Module1.167 (GND), Module1.168 (GND), Module1.173 (GND), Module1.174 (GND), Module1.179 (GND), Module1.180 (GND), Module1.185 (GND), Module1.186 (GND), Module1.191 (GND), Module1.192 (GND), Module1.197 (GND), Module1.198 (GND), Q1.3 (S), Q2.3 (E), Q2#2.3 (E), Q4.3 (E), Q7.3 (E), Q9.3 (E), Q10.3 (E), Q10#2.3 (E), Q12.3 (E), Q15.3 (E), Q15#2.3 (E), Q17.3 (E), R10.2, R13.2, R14.2, R21.2, R22.2, R24.2, R25.2, R26.1, R30.2, R37.2, R38.2, R39.2, R40.2, R41.2, R42.2, R47.2, R52.1, R53.2, R58.2, R66.2, R71.2, R72.1, R77.2, R87.1, U1.3 (GND), U4.3 (GND), U5.2 (GND), U6.1 (GND), U7.2 (GND), U8.53 (GND), U8.65 (GND), U9.56 (TESTn), U9.58 (GND), U9.59 (GND), U9.65 (ePAD), U10.4 (GND), U10.9 (EXP), U11.56 (TESTn), U11.58 (GND), U11.59 (GND), U11.65 (ePAD), U12.3 (~WP), U12.4 (GND), U12.9 (EXP), Y1.2, Y1.4, Y2.2, Y2.4, Y3.2, Y3.4
