oli528/StorePi/(commit log)

2025-06-10 Initial Comment
    No design
    [Block Diagram.kicad_sch, CM5 Nas.kicad_pcb, CM5 Nas.kicad_sch, Power - Sequencing.kicad_sch, Project Architecture.kicad_sch, Revision History.kicad_sch, Section A - Title A.kicad_sch, Section B - TItle B.kicad_sch]
2025-06-10 Progress on Block Diagram
    [Block Diagram.kicad_sch, CM5 Nas.kicad_sch, Project Architecture.kicad_sch, Revision History.kicad_sch, Section A - Title A.kicad_sch, Section B - TItle B.kicad_sch]
2025-06-10 PSU added
    [Block Diagram.kicad_sch]
2025-06-11 CM5 IO done
    [Section A - Title A.kicad_sch, Section B - TItle B.kicad_sch]
2025-06-11 Progress in power input and sata power option
    [CM5 Nas.kicad_sch, Drives.kicad_sch, PCIe-M2.kicad_sch, Project Architecture.kicad_sch, Revision History.kicad_sch, Section A - Title A.kicad_sch, Section B - TItle B.kicad_sch]
2025-06-12 Libaries added
    [CM5 Nas.kicad_sch, Drives.kicad_sch, Layout calcs.xlsx, PCIe-M2.kicad_sch]
2025-06-12 Your commit message
    [NASDrives.kicad_sch]
2025-06-17 Voltage calcs
    [Book1.xlsx, Drives.kicad_sch, Project Architecture.kicad_sch, Sata_Drives.kicad_sch, Section A - Title A.kicad_sch, Section B - TItle B.kicad_sch]
2025-06-18 Digital Reg with multiple v
    [Drives_M.2.kicad_sch, Power.kicad_sch, Project Architecture.kicad_sch]
2025-06-18 Digital Reg Changed
    [Drives_M.2.kicad_sch, Power.kicad_sch]
2025-06-19 Footprints added
    [Drives_M.2.kicad_sch]
2025-06-19 block diagram updated
    [Block Diagram.kicad_sch]
2025-06-19 Drives moved
    [Block Diagram.kicad_sch, Drives_M.2.kicad_sch, Project Architecture.kicad_sch]
2025-06-21 Sheet name edit and changed to net labels
    [Block Diagram.kicad_sch, CM5 Nas.kicad_sch, Drives_M.2.kicad_sch, Power.kicad_sch, Project Architecture.kicad_sch, Section A - Title A.kicad_sch, Section B - TItle B.kicad_sch]
2025-06-23 Notation changed on M.2 Sheet
    [Drives_M.2.kicad_sch, Project Architecture.kicad_sch, Sata_Drives.kicad_sch, Section A - Title A.kicad_sch]
2025-06-25 Started Ethernet design
    [CM5 Nas.kicad_sch, Drives_M.2.kicad_sch, Power.kicad_sch, Project Architecture.kicad_sch, USB & Ethernet.kicad_sch]
2025-06-26 Buck converter output voltage changed
    [Power.kicad_sch, Project Architecture.kicad_sch, Section B - TItle B.kicad_sch, USB & Ethernet.kicad_sch]
2025-06-29 etherenet schematic
    [Section B - TItle B.kicad_sch, USB & Ethernet.kicad_sch]
2025-06-29 switched from KSZ9893RNX to SJA1105PEL for sgmii support
    [USB & Ethernet.kicad_sch]
2025-07-02 Swiitched to JSM561
    [Block Diagram.kicad_sch, Drives_M.2.kicad_sch, Power.kicad_sch, Project Architecture.kicad_sch, Sata_Drives2.kicad_sch, Section A - Title A.kicad_sch, Section B - TItle B.kicad_sch, USB & Ethernet.kicad_sch]
2025-07-03 Removed Ethernet
    [Block Diagram.kicad_sch, CM5 Nas.kicad_sch, Drives_M.2.kicad_sch, Power.kicad_sch, Project Architecture.kicad_sch, Sata_Drives.kicad_sch, Sata_Drives2.kicad_sch, Section A - Title A.kicad_sch]
2025-07-03 Sheets neatened
    [Drives_M.2.kicad_sch, Sata_Drives.kicad_sch, Sata_Drives2.kicad_sch, Section A - Title A.kicad_sch, Section B - TItle B.kicad_sch, USB & Ethernet.kicad_sch]
2025-07-04 More Fans
    [Drives_M.2.kicad_sch, Project Architecture.kicad_sch, Sata_Drives.kicad_sch, Sata_Drives2.kicad_sch, Section B - TItle B.kicad_sch, USB & Ethernet.kicad_sch]
2025-07-05 RP2040 Added, Files Structure Changed
    [Block Diagram.kicad_sch, Book1.xlsx, CM5 Nas.kicad_pcb, CM5 Nas.kicad_sch, Drives_M.2.kicad_sch, Layout calcs.xlsx, NASDrives.kicad_sch, Power - Sequencing.kicad_sch]
2025-07-05 Rp2040 Power Sequence finished and general cleaning
    [Drives_M.2.kicad_sch, Project Architecture.kicad_sch, RP2040.kicad_sch, Sata_Drives.kicad_sch, Sata_Drives2.kicad_sch, Section A - Title A.kicad_sch, Section B - TItle B.kicad_sch, USB & Ethernet.kicad_sch]
2025-07-06 Starting the Sheet connections
    [Book1.xlsx, Drives_M.2.kicad_sch, Power.kicad_sch, Project Architecture.kicad_sch, Sata_Drives.kicad_sch, Sata_Drives2.kicad_sch, Section A - Title A.kicad_sch, Section B - TItle B.kicad_sch]
2025-07-08 Footprints Selected
    [Block Diagram.kicad_sch, Book1.xlsx, Drives_M.2.kicad_sch, Input.kicad_sch, Power.kicad_sch, Project Architecture.kicad_sch, RP2040.kicad_sch, Sata_Drives.kicad_sch]
2025-07-13 Footprints selected, Hiracicle connections created, Pcb next
    [Block Diagram.kicad_sch, CM5 Nas.kicad_pcb, CM5 Nas.kicad_sch, Drives_M.2.kicad_sch, Power.kicad_sch, Project Architecture.kicad_sch, RP2040.kicad_sch, Sata_Drives.kicad_sch]
2025-07-14 Sata Port Changed
    [CM5 Nas.kicad_sch, Drives_M.2.kicad_sch, Power.kicad_sch, Project Architecture.kicad_sch, Sata_Drives2.kicad_sch, Section A - Title A.kicad_sch, Section B - TItle B.kicad_sch, USB & Ethernet.kicad_sch]
2025-07-16 Changed sata port
    [CM5 Nas.kicad_pcb, Drives_M.2.kicad_sch, Power.kicad_sch, Project Architecture.kicad_sch, Sata_Drives.kicad_sch, Sata_Drives2.kicad_sch, Section A - Title A.kicad_sch, Section B - TItle B.kicad_sch]
2025-07-16 More pcbing
    [CM5 Nas.kicad_pcb, Drives_M.2.kicad_sch, Power.kicad_sch, Project Architecture.kicad_sch, Sata_Drives.kicad_sch, Sata_Drives2.kicad_sch, Section A - Title A.kicad_sch, Section B - TItle B.kicad_sch]
2025-08-04 More pcb arangment, verticle ports
    [0039281063.SchLib, 0877131001.SchLib, 10029364-001LF.SchLib, 47018-2000.SchLib, 4DB-P108-03.SchLib, AOZ2255EQI-30.SchLib, AP62800SJ-7.SchLib, ASM1352R.SchLib]
